Tiag0Carvalh0/Hardware_Development_Pratical_Work/TPF_Final_GP8/Aquecedor_inteligente_Apresentacao_G8.pdf

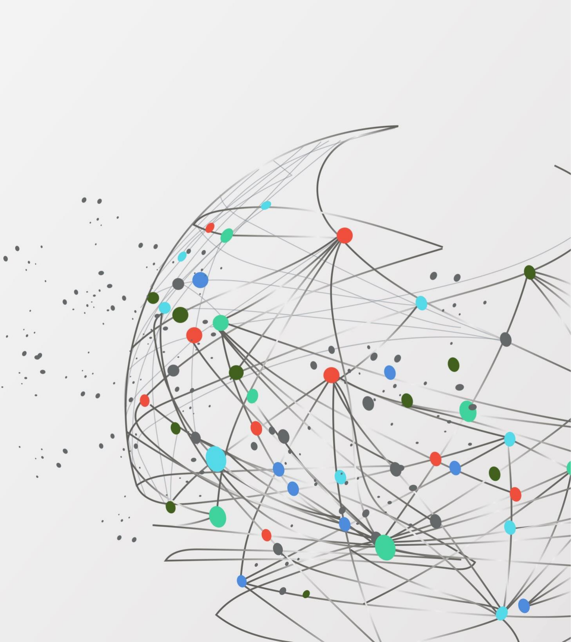
[picture p12: figure]

# Aquecedor inteligente

G RU P O 8

T I AG O C A RVA L H O , A 1 8 6 0 1

PAT R Í C I A PE X OTO, A 1 9 6 2 6

J OS É SA N TOS, A 1 8 6 0 5

# Âmbito do projeto

Este projeto enquadra-se na disciplina de Laboratório de desenvolvimento de hardware, nomeadamente o trabalho prático 2.

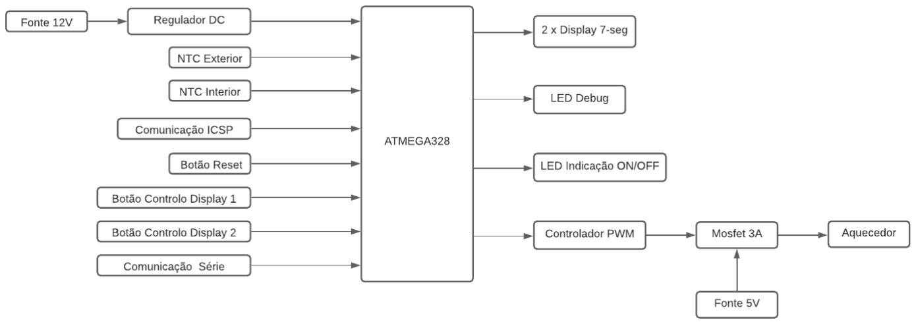
[picture p13: figure]

# Diagrama de blocos

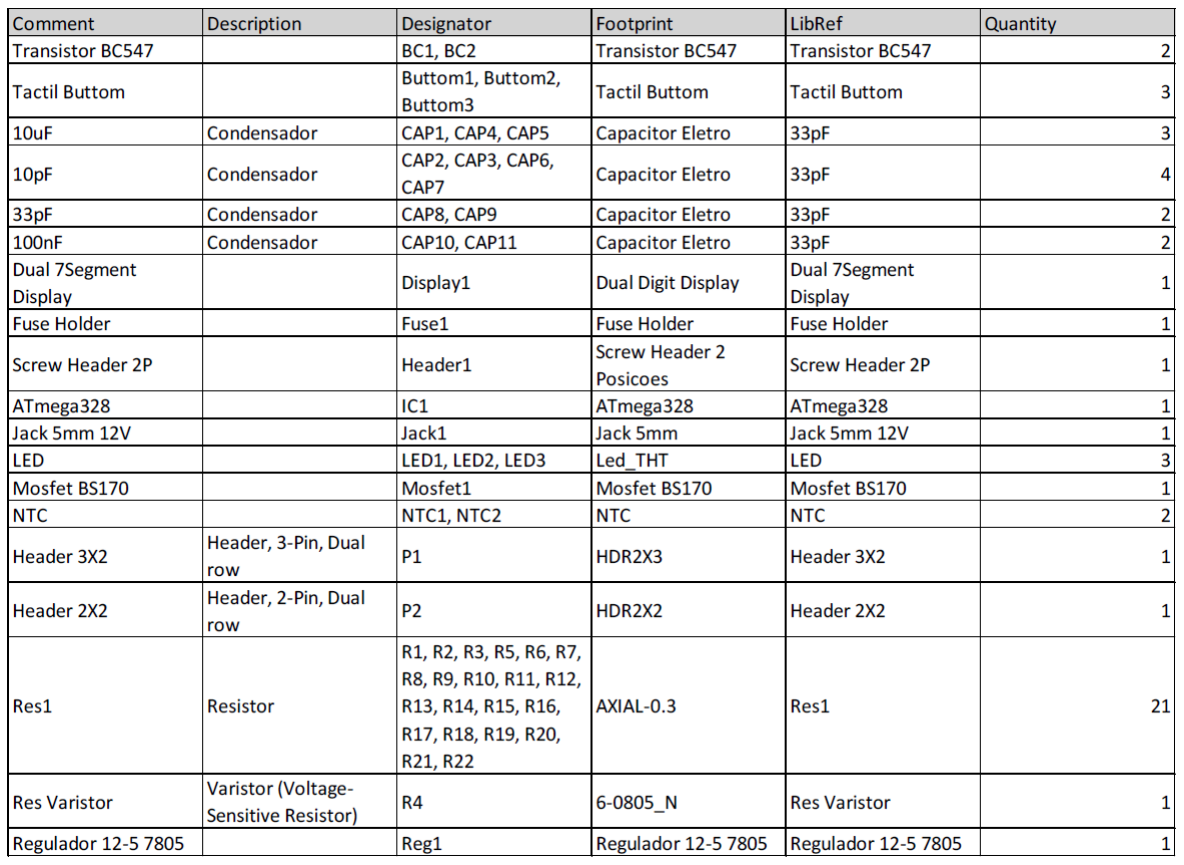
[picture p14: figure]

# BOM

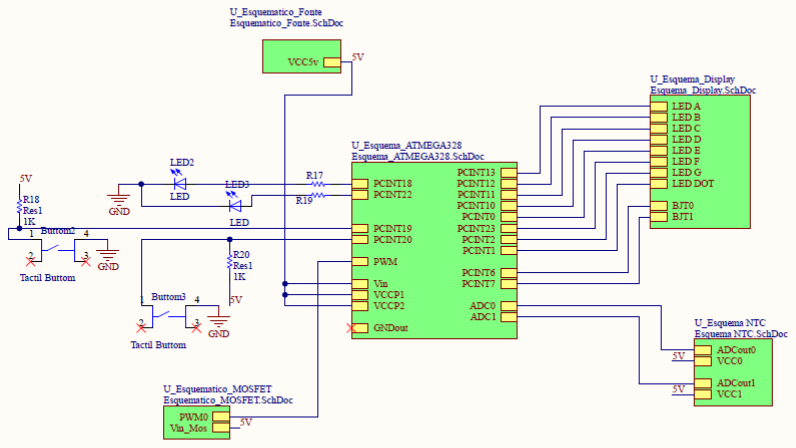
[picture p15: figure]

# Schematic do projeto

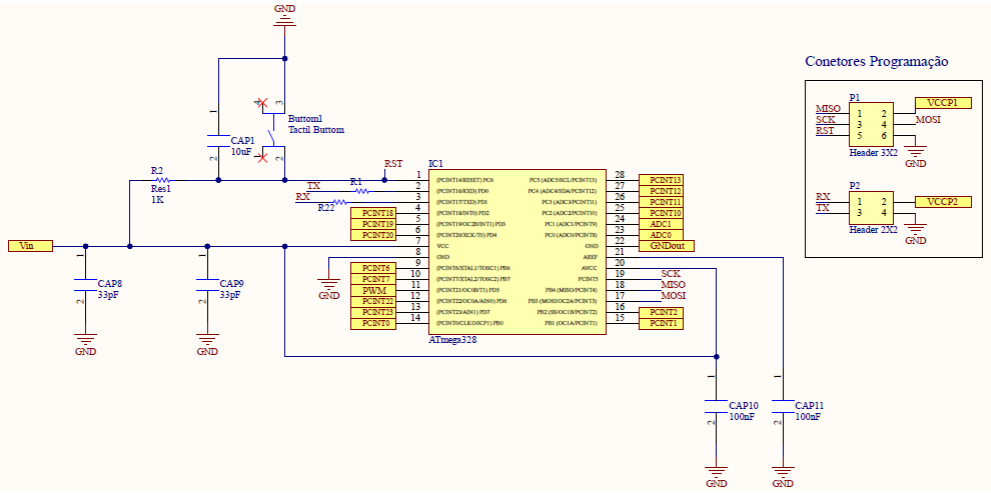
[picture p16: figure]

# Schematic ligações ao Atmega328

# Schematic das NTC

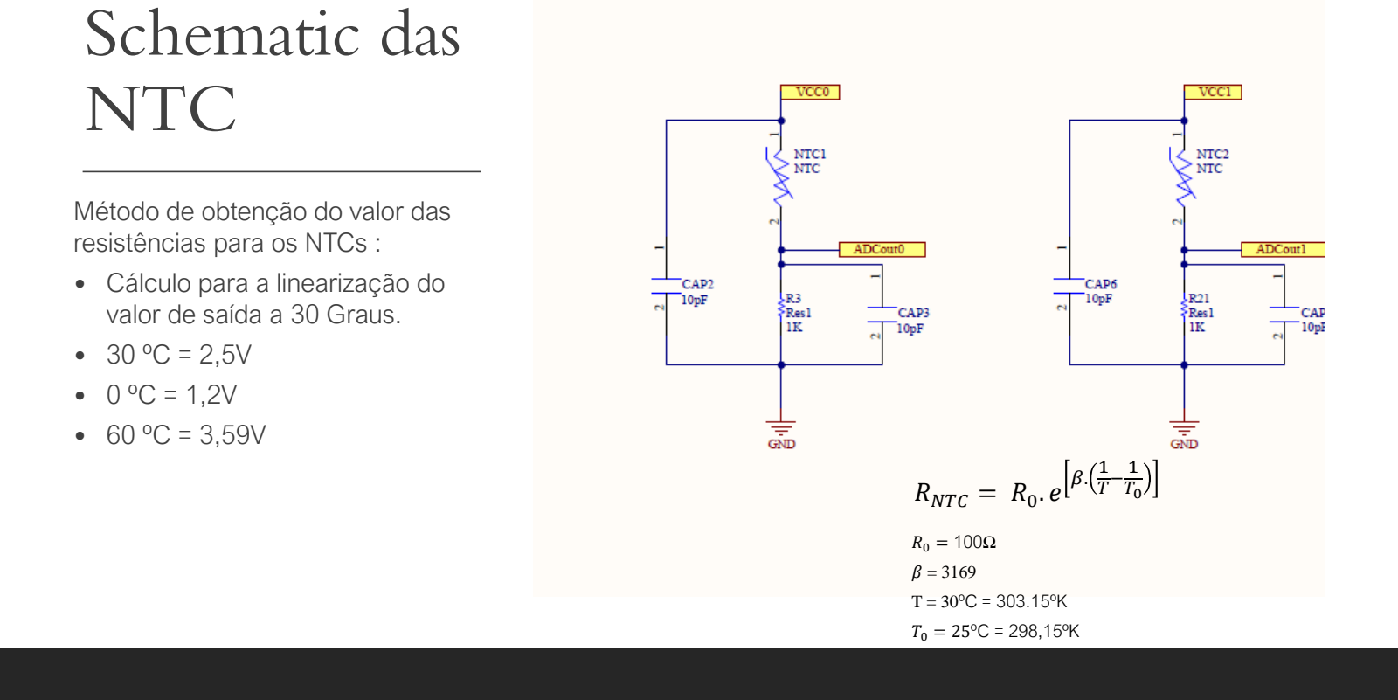
[picture p17: page 7]

Método de obtenção do valor das resistências para os NTCs : • Cálculo para a linearização do

valor de saída a 30 Graus.
- 30 ºC = 2,5V • 0 ºC = 1,2V • 60 ºC = 3,59V

RNTC

=

R

0. e

β. 1T
−

1T0

R
0

= 100
Ω

β = 3169

T = 30ºC = 303.15ºK T0 = 25ºC = 298,15ºK

# Schematic da fonte de alimentação

- Regulador para baixar a tensão para os 5V
- Condensadores para estabilizar a tensão na saída.
- Fusível para proteger o circuito

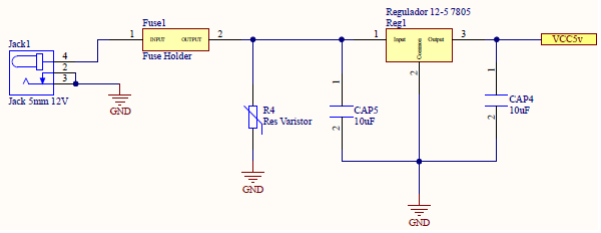
[picture p18: figure]

# Schematic dos displays de 7 segmentos

- Transistores permitem
alternar entre os displays.

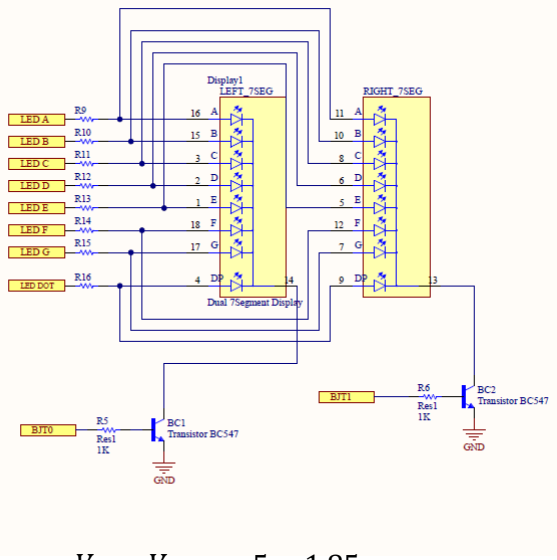
[picture p19: figure]

R =

Vin − VTyp
I

=

5 − 1.85
0.0175

= 180Ω

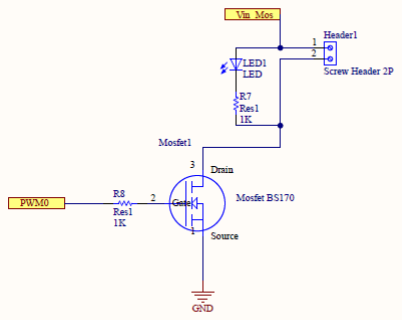
[picture p20: figure]

# Schematic do Mosfet

Controlo da carga elétrica do aquecedor
- Atmega328 não tem a capacidade de alimentar dispositivos com potência elevada.

# 3D da PCB

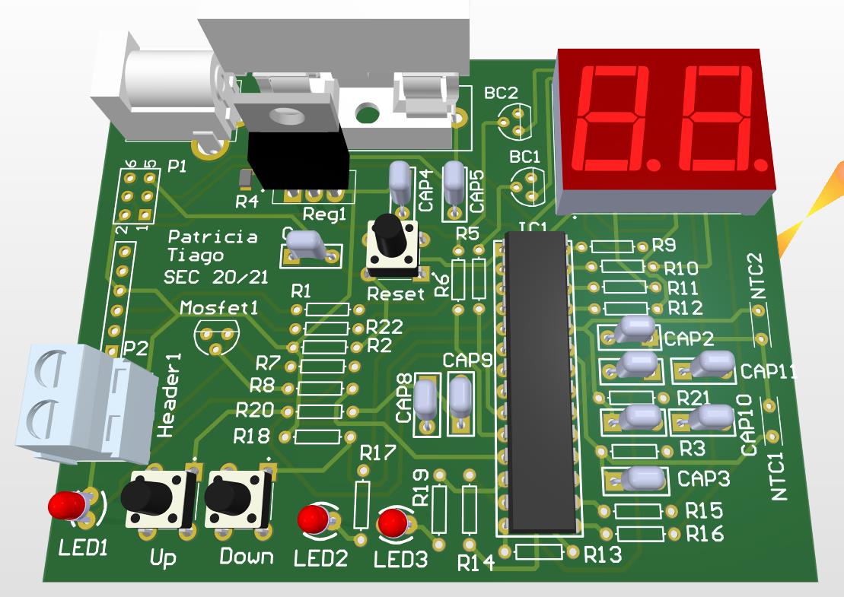
[picture p21: figure]

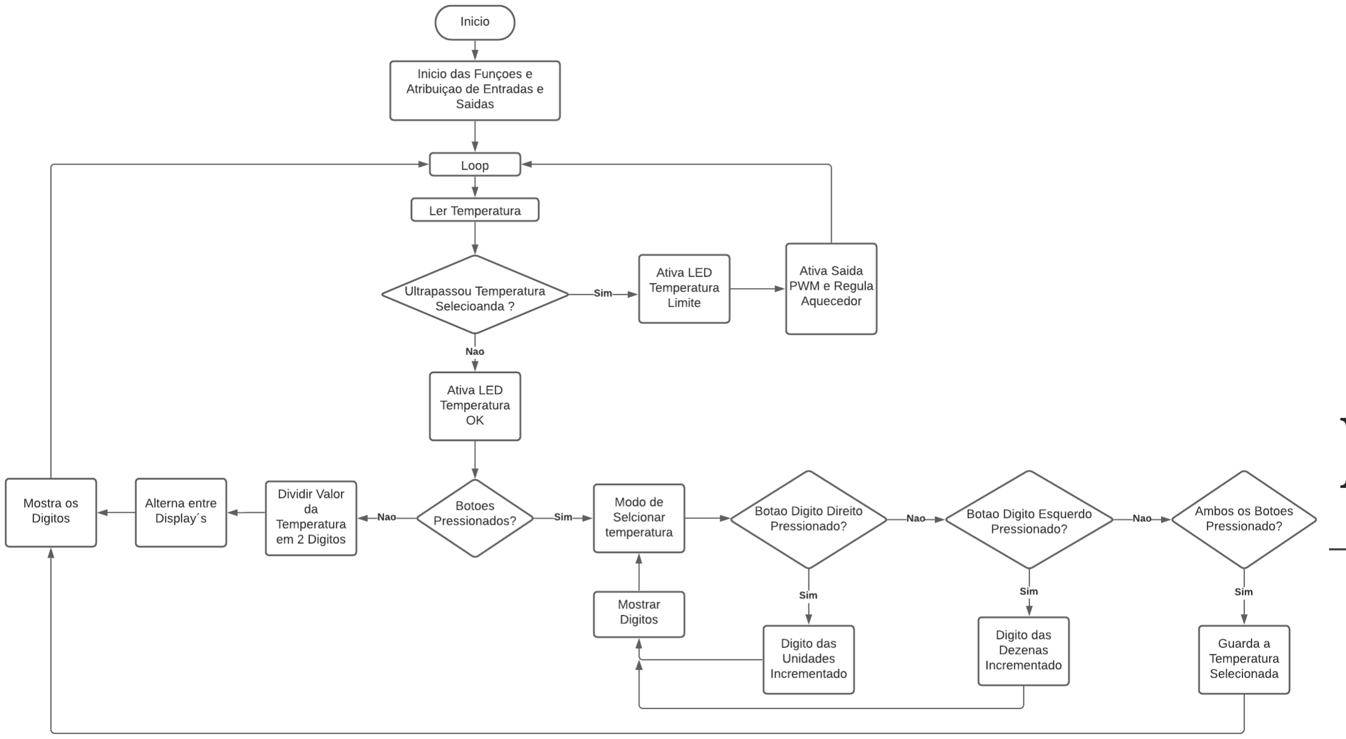
[picture p22: figure]

# Fluxograma

# PCB

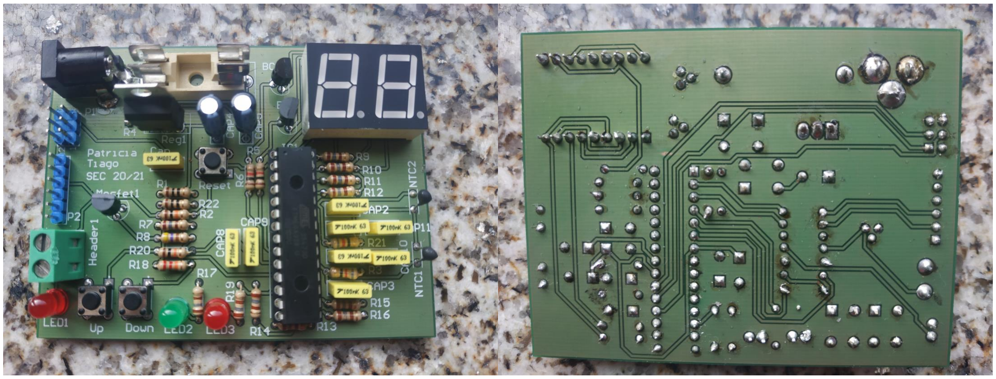
[picture p23: figure]

# Funcionalidades atuais

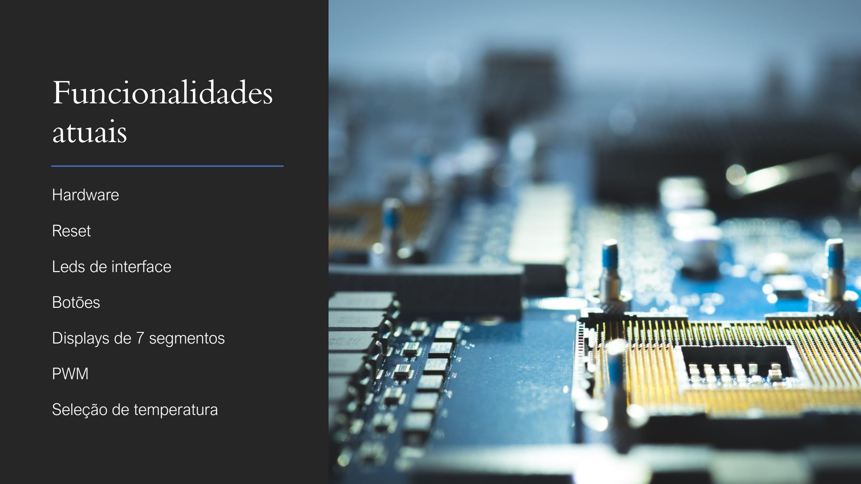
[picture p24: page 14]

Hardware

Reset

Leds de interface

Botões

Displays de 7 segmentos

PWM

Seleção de temperatura

## Fim AGRADECEMOS A ATENÇÃO
