Tiag0Carvalh0/Hardware_Development_Pratical_Work/TPF_Final_GP8/Lista_Material_G8.pdf

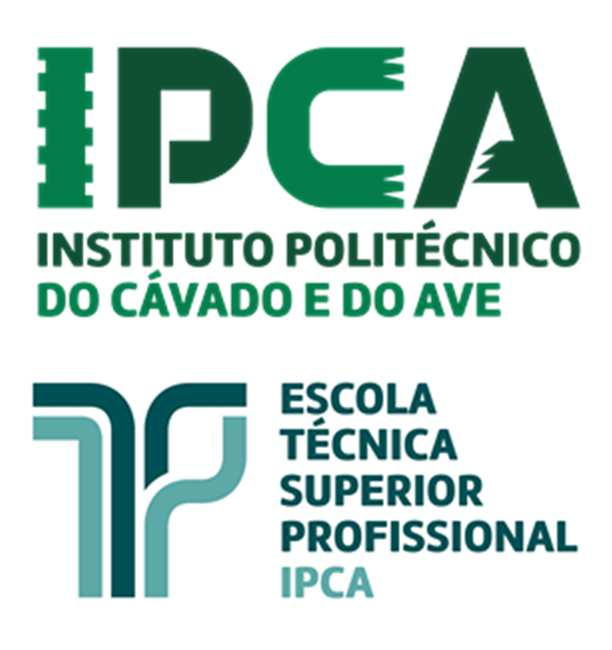
[picture p25: figure]

Relatório Prático

Aquecedor Inteligente

Janeiro,2021

UteSP – Sistemas Eletrónicos e Computadores

Professor:

Carlos Ferreira & Carlos Silva

Autores:

Grupo 8

Patrícia Peixoto, Tiago Carvalho & José Santos

Lista de Material

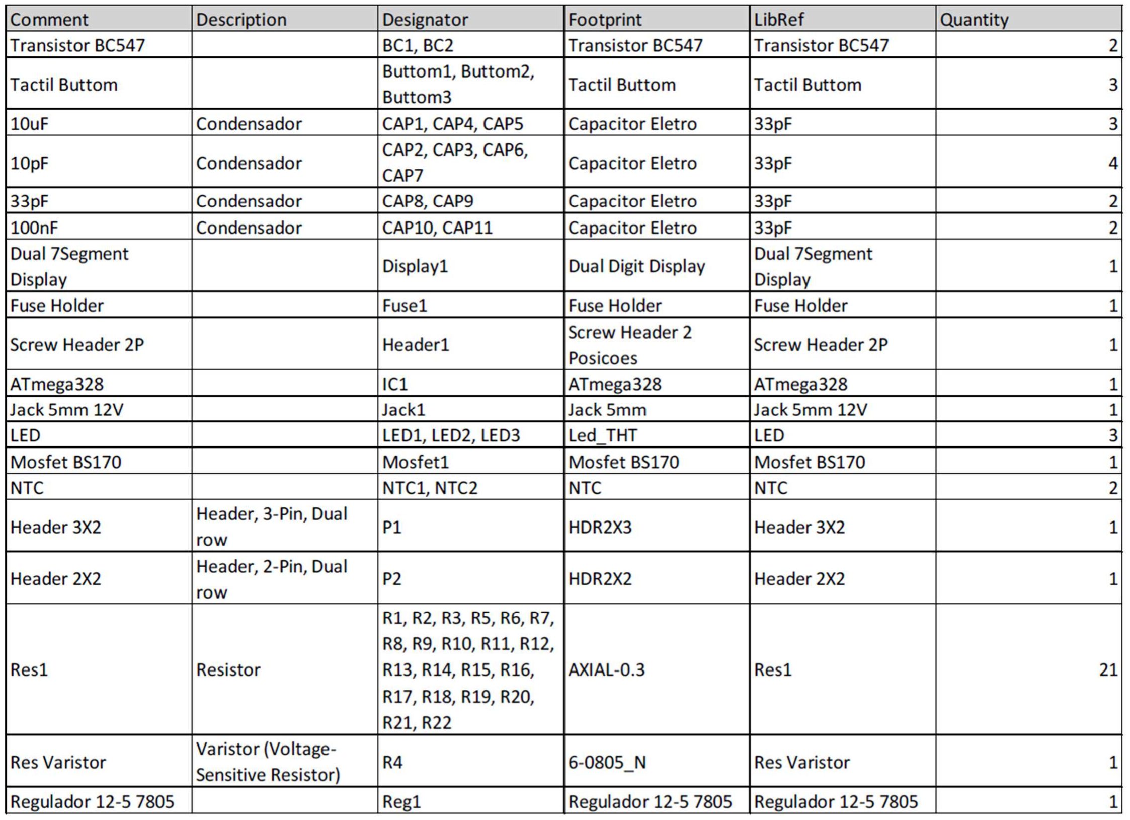
[picture p26: figure]
