Tiag0Carvalh0/Hardware_Development_Pratical_Work/TPF_Final_GP8/Aquecedor_Inteligente_Layout_G8.pdf

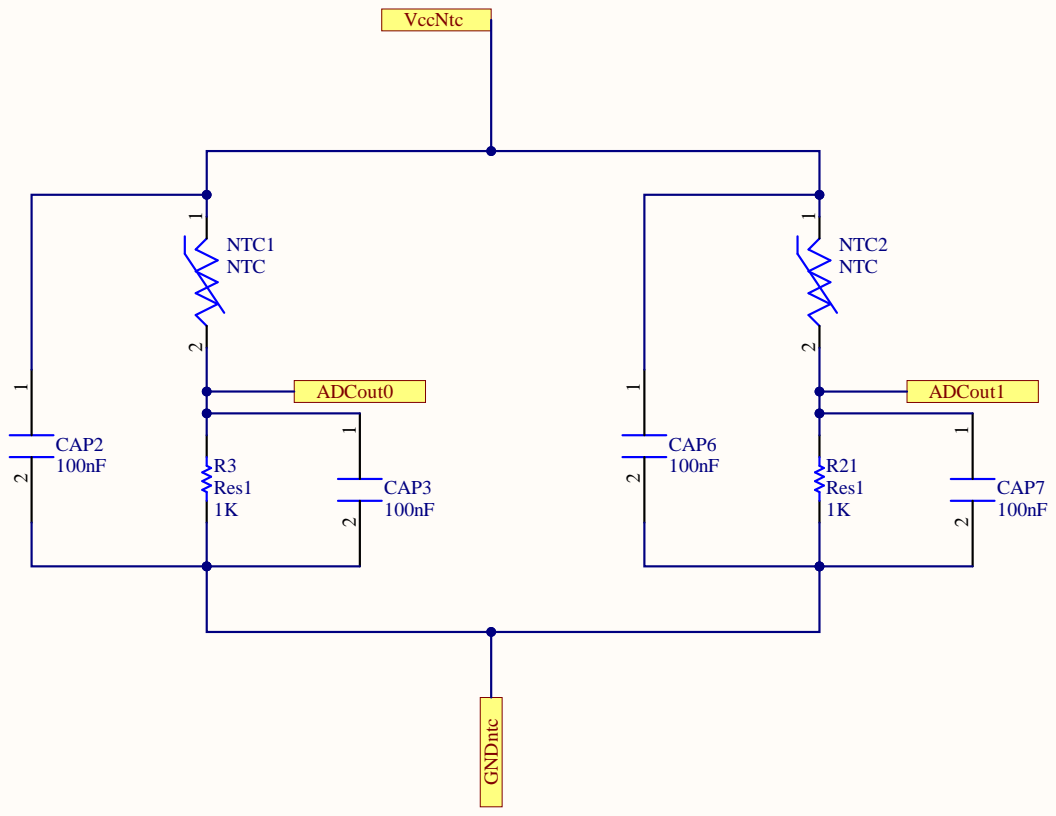
[picture p27: page 1]

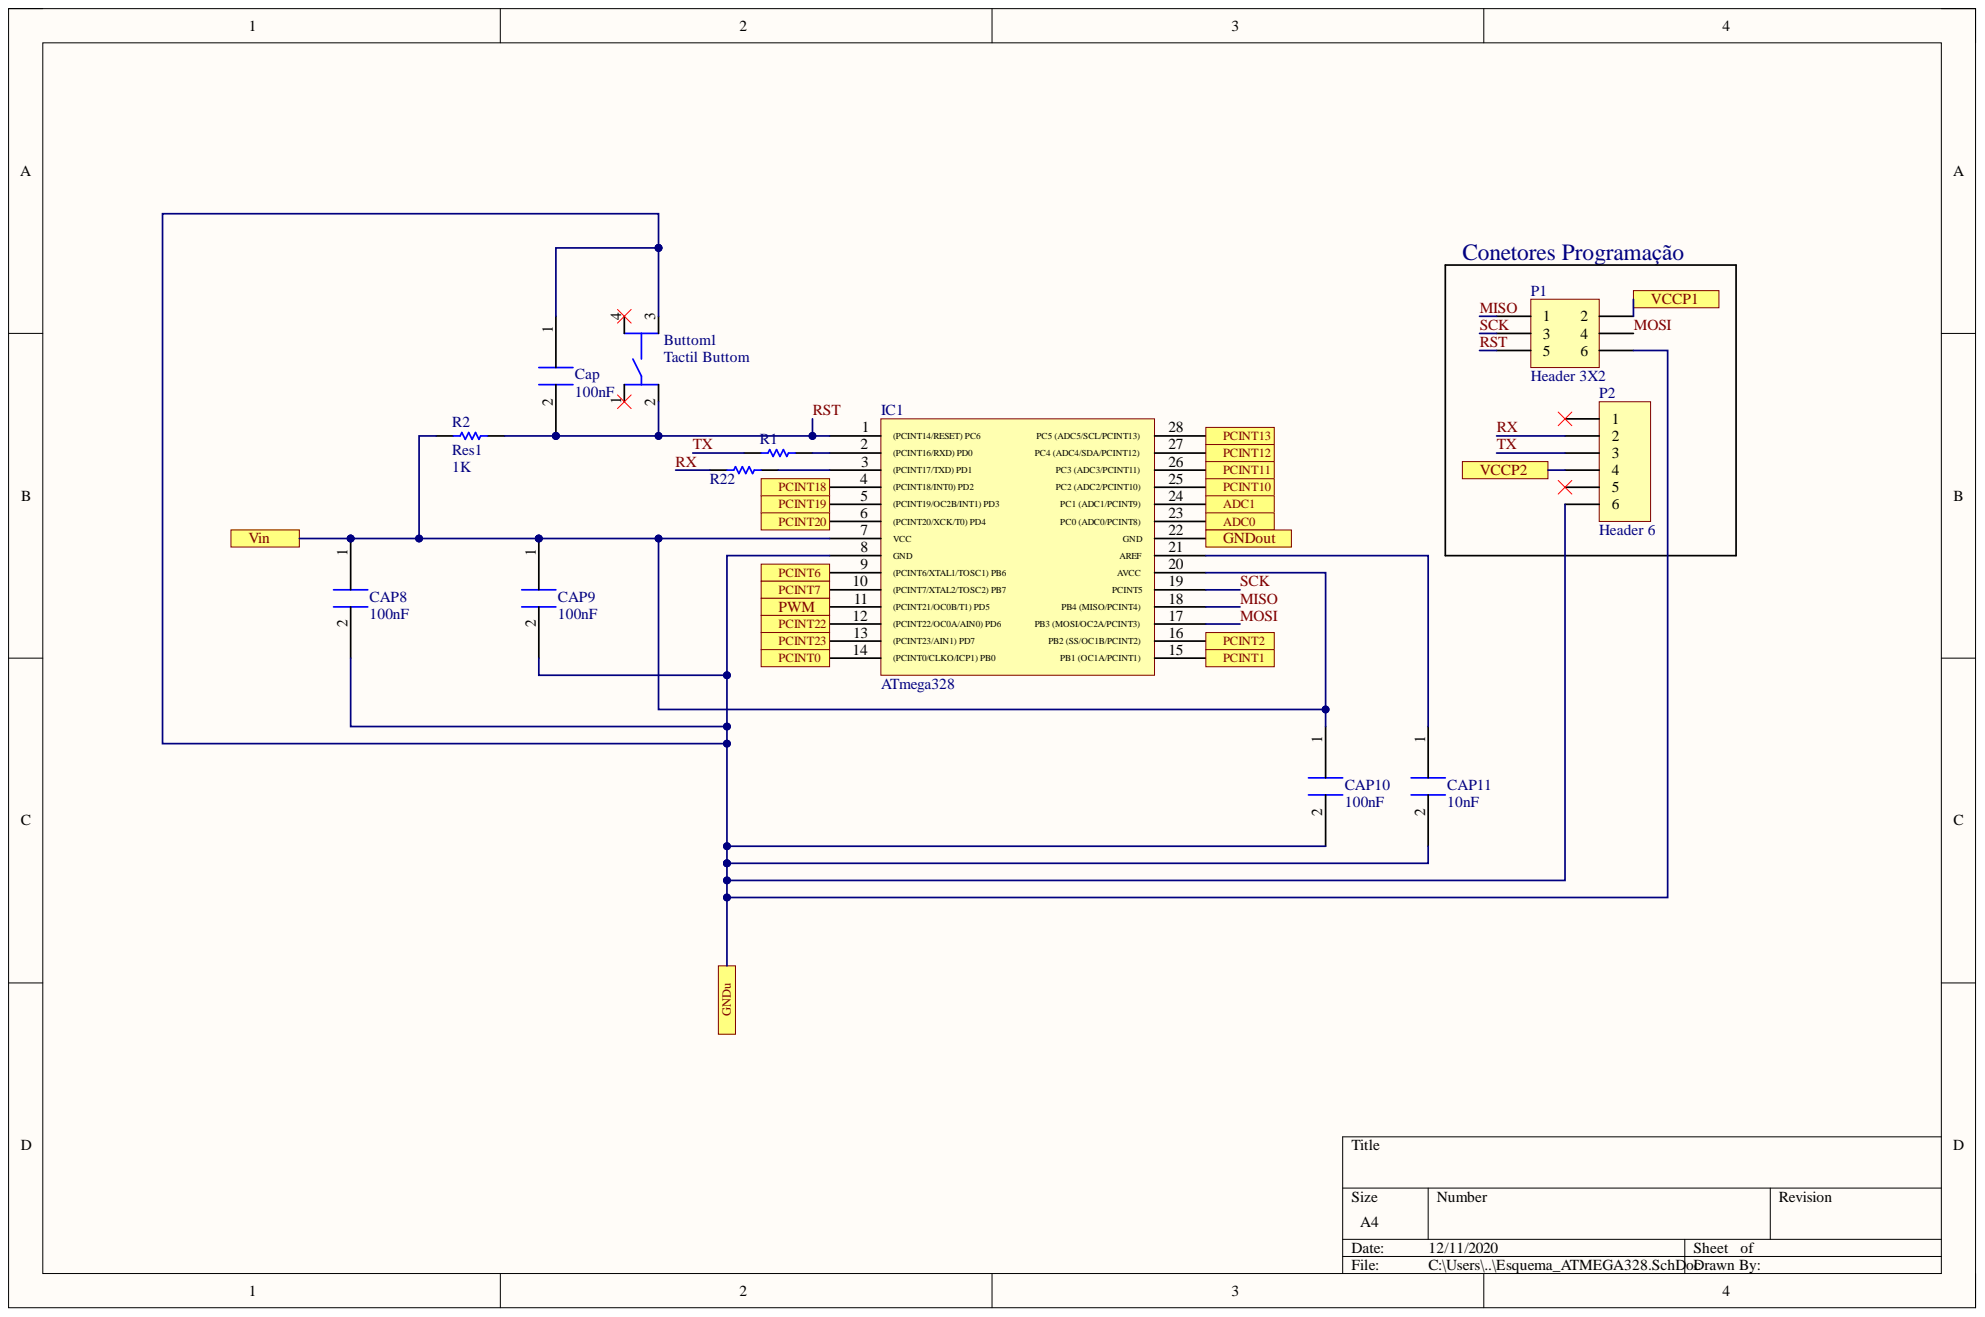
[picture p28: page 2]

PCINT18 | PCINT10
PCINT19 | ADC1

CAP8 | CAP9 | | GND 8 AREF AVCC PCINT5 PB4 (MISO/PCINT4) PB3 (MOSI/OC2A/PCINT3) PB2 (SS/OC1B/PCINT2) PB1 (OC1A/PCINT1) | 21

(PCINT6/XTAL1/TOSC1) PB6 9 | 20 | | CAP11

(PCINT7/XTAL2/TOSC2) PB7 10 | 19 18 17 16 | SCK MISO MOSI

(PCINT0/CLKO/ICP1) PB0 14 | 15

PCINT0 | PCINT1

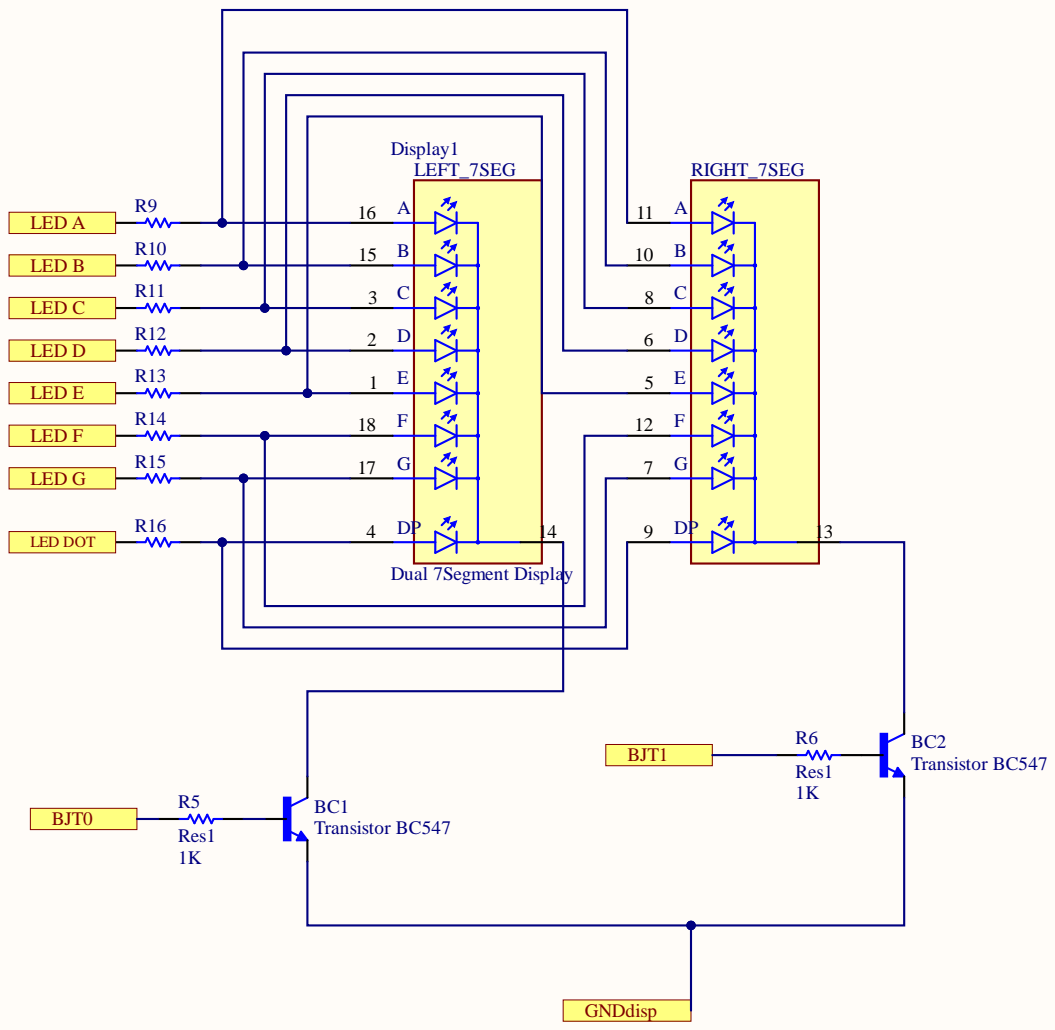
[picture p29: page 3]

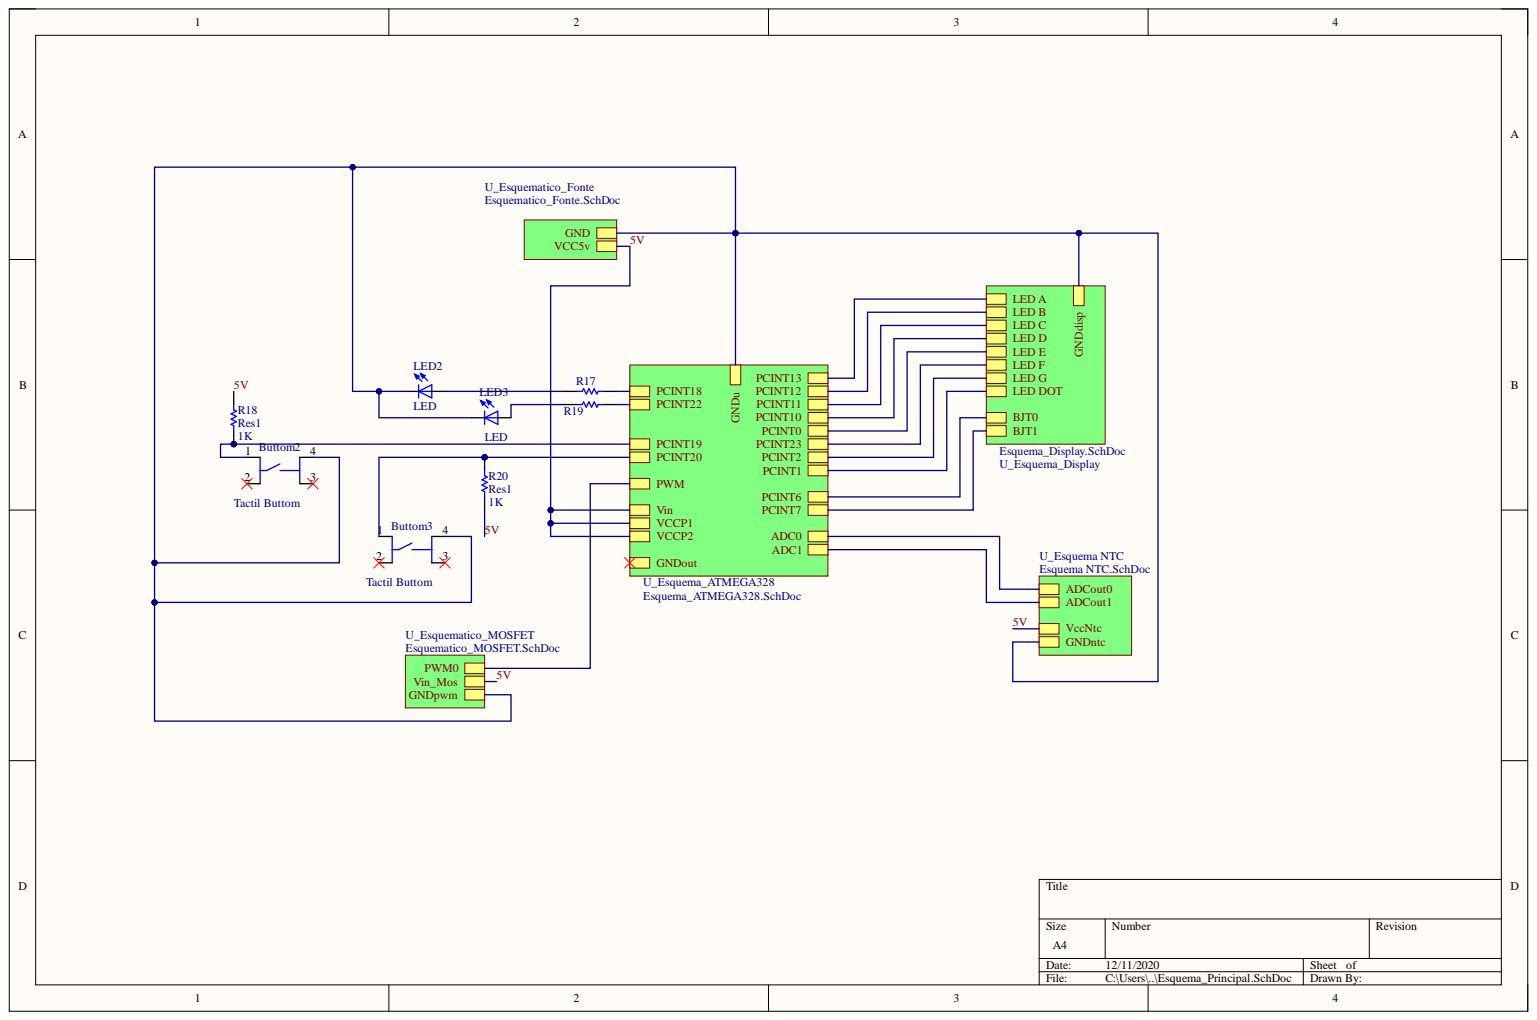
[picture p30: page 4]

1 Buttom2 4

Tactil Buttom | | | 1 | R20

Res1 1K 5V

2 Tactil Buttom | Esquematico_MOSFET.SchDoc

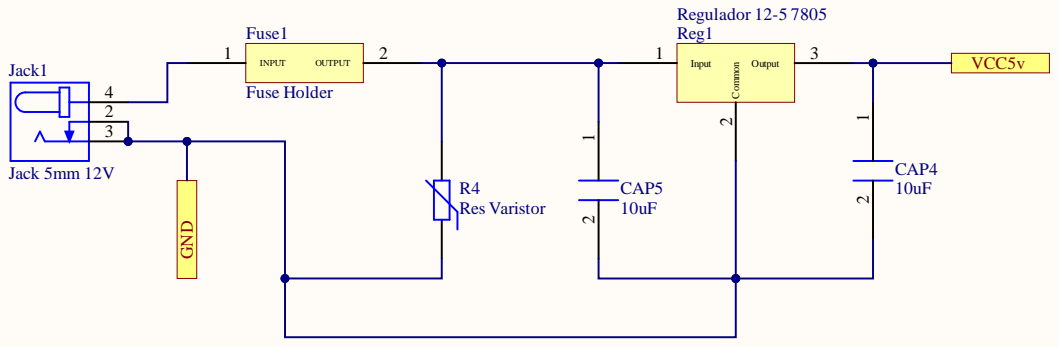
[picture p31: page 5]

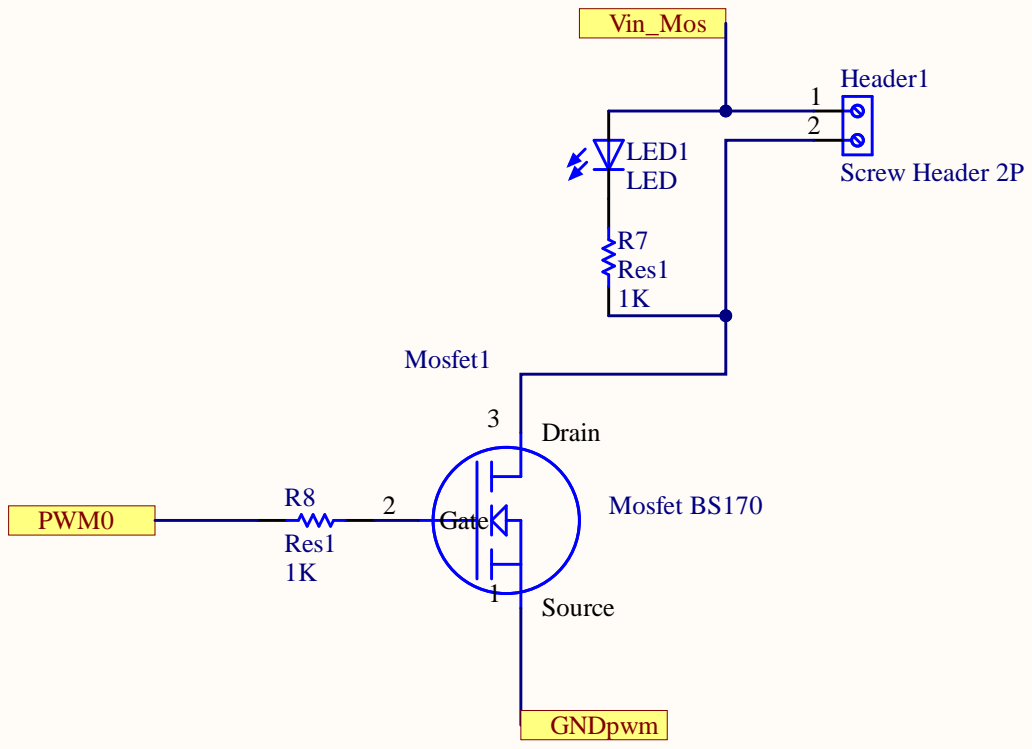
[picture p32: page 6]

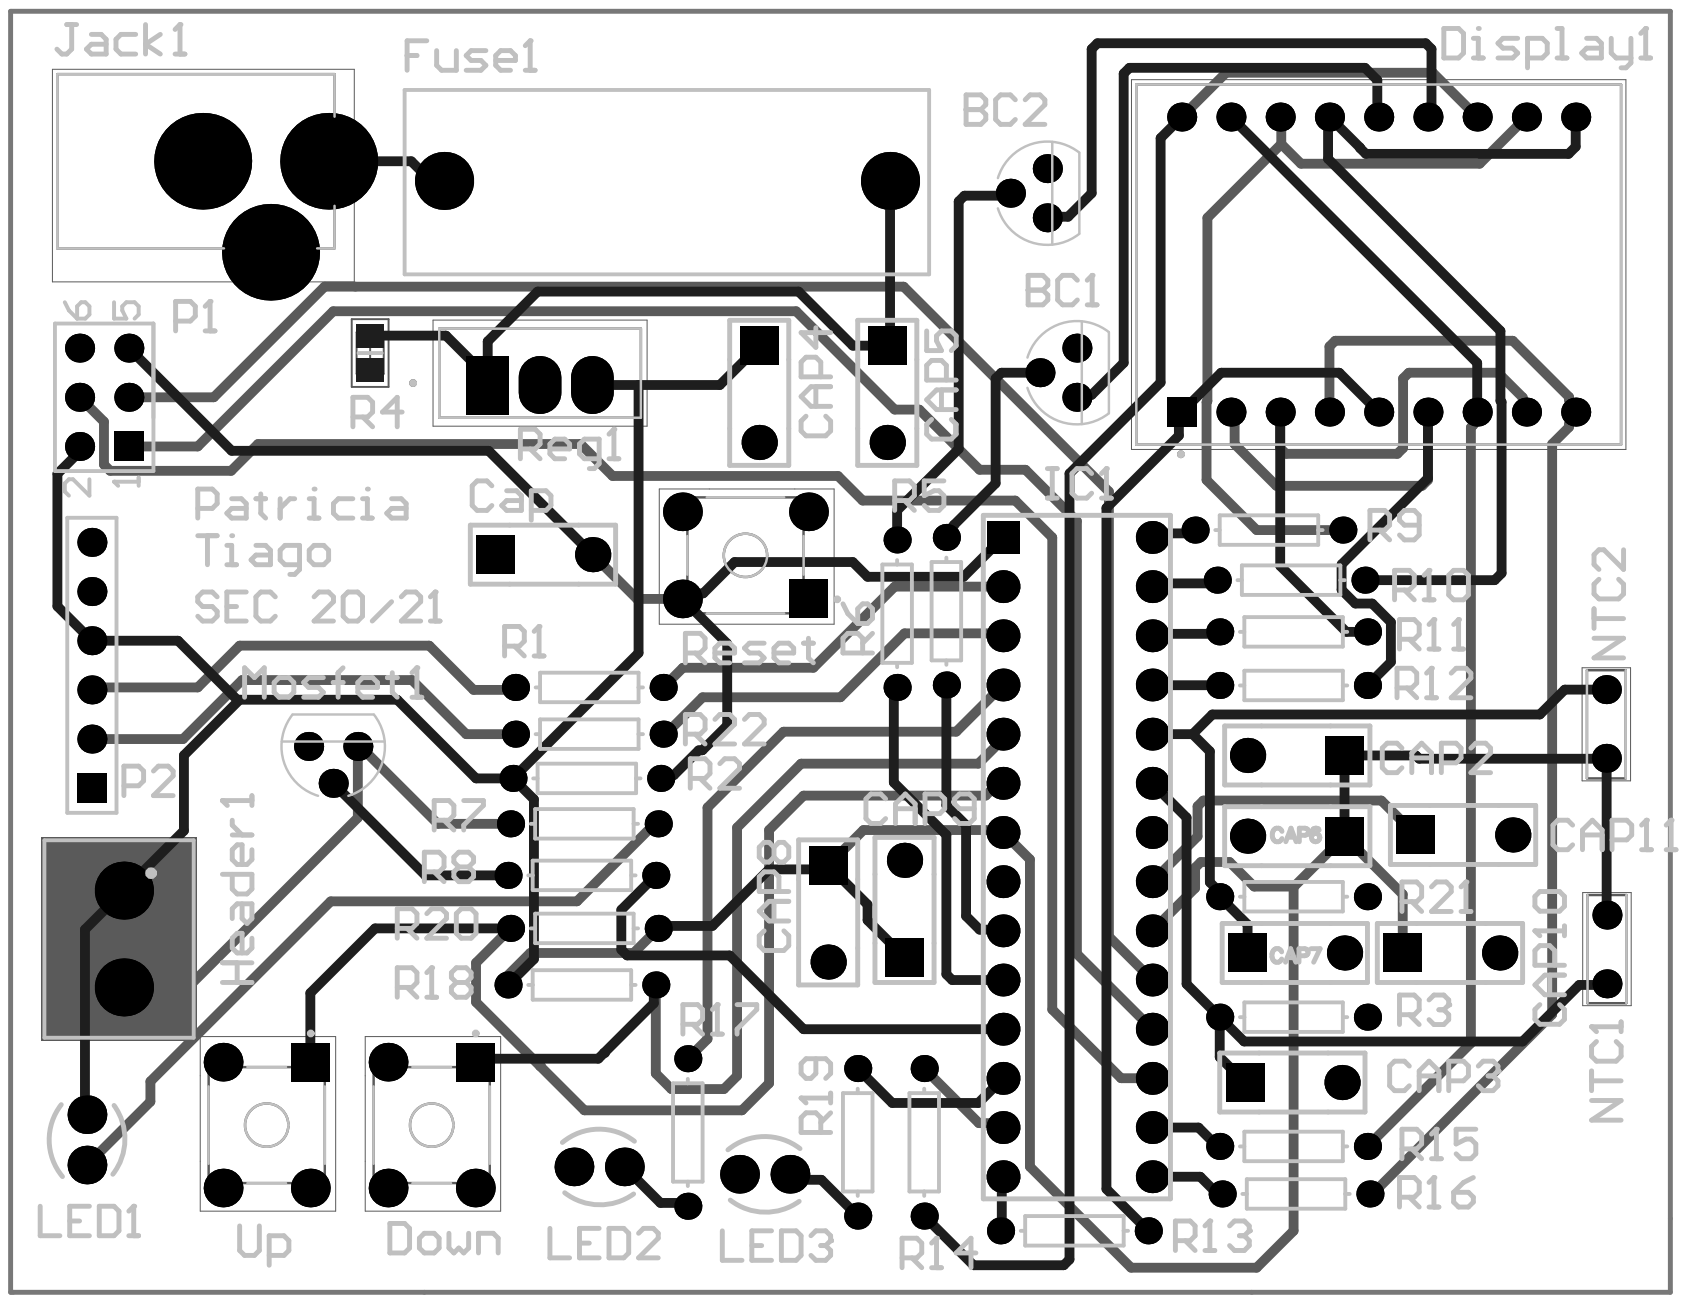
[picture p33: page 7]
