Tiag0Carvalh0/Hardware_Development_Pratical_Work/(list of files, drawings)

Other design files:
Aquecedor_Intelifente_PCB/Aquecedor_Inteligente/Aquecedor_Inteligente.PrjPcb
Aquecedor_Intelifente_PCB/Aquecedor_Inteligente/Esquema NTC.SchDoc
Aquecedor_Intelifente_PCB/Aquecedor_Inteligente/Esquema_ATMEGA328.SchDoc
Aquecedor_Intelifente_PCB/Aquecedor_Inteligente/Esquema_Display.SchDoc
Aquecedor_Intelifente_PCB/Aquecedor_Inteligente/Esquema_Principal.SchDoc
Aquecedor_Intelifente_PCB/Aquecedor_Inteligente/Esquematico_Fonte.SchDoc
Aquecedor_Intelifente_PCB/Aquecedor_Inteligente/Esquematico_MOSFET.SchDoc
Aquecedor_Intelifente_PCB/Aquecedor_Inteligente/PCB_Aquecedor.PcbDoc
